lqdung24/stm32_quad/stm32cube/README.md

# Hướng dẫn đi dây drone STM32H743 + ESP32-S3

> **An toàn:** Tháo toàn bộ cánh quạt trước khi cấp nguồn hoặc thử motor.
> Không cấp nguồn motor/ESC từ STM32 hay ESP32.

## 1. Sơ đồ tổng quát

```text
Điện thoại
    │ Wi-Fi
    ▼
ESP32-S3 ── UART 460800 ── STM32H743 ── PWM/DShot ── ESC 1 ── Motor 1
    │                         │                       ESC 2 ── Motor 2
    │                         │                       ESC 3 ── Motor 3
    │                         │                       ESC 4 ── Motor 4
    │                         │
    GND───────────────────────GND──────────────────── GND các ESC

Pin/battery (+) ───────────────────────────────────── Nguồn động lực các ESC
Pin/battery (-) ───────────────────────────────────── GND nguồn động lực
```

Tất cả ESP32-S3, STM32 và ESC phải có **GND chung**.

## 2. ESP32-S3 nối STM32H743

ESP32-S3: VCC | GND | RX | TX

STM32: RX | TX | GND | VCC

| ESP32-S3 | STM32H743 | Chức năng |
| --- | --- | --- |
| GPIO17, UART1 TX | PA10, USART1 RX | Lệnh điều khiển ESP32 → STM32 |
| GPIO18, UART1 RX | PA9, USART1 TX  | Trạng thái STM32 → ESP32 |
| GND | GND | Mass tín hiệu chung |

Cấu hình UART hai bên:

- Baud rate: `460800`
- 8 data bits, no parity, 1 stop bit (`8N1`)
- Chế độ bất đồng bộ, TX/RX
- Mức logic `3.3 V`

Không nối UART vào điện áp `5 V`. Không dùng TX0/RX0 của ESP32-S3 nếu UART0
vẫn đang được dùng cho console/debug 115200 baud.

## Telemetry Wi-Fi 50 Hz

STM32 gửi packet `FLIGHT_TELEMETRY` 50 byte (có CRC) tối đa mỗi `20 ms` qua
UART. ESP chỉ giữ sample mới nhất rồi phát binary WebSocket ở
`ws://192.168.4.1/telemetry`; kênh điều khiển `/ws` vẫn độc lập. AP cho phép
hai thiết bị: điện thoại điều khiển và máy tính ghi/plot.

Các trường gồm timestamp STM32, roll/pitch/yaw (độ), gyro BODY-FRD và
rate-setpoint (rad/s), PID correction mixer, PWM M1..M4, `armed/state`, cờ
actuator active và cờ attitude valid. Trên máy tính, chạy từ thư mục gốc:

Trường wire `pwm_pulse_us` được giữ để tương thích protocol. Với DShot, giá trị
này là biểu diễn normalized tương đương 1000..2000, không phải DShot raw value.

```sh
python3 -m pip install websocket-client matplotlib
python3 tools/telemetry_plot.py --csv flight.csv
```

Lệnh thêm `--no-plot` để chỉ ghi CSV. Telemetry là best-effort và có thể bỏ
sample khi Wi-Fi chậm; nó không được phép làm chậm lệnh điều khiển.

## 3. STM32 nối bốn ESC

Chiều quay được xác định khi nhìn từ trên xuống drone. Ngưỡng idle cấu hình
có thêm `20 µs` so với mức motor bắt đầu quay đo được khi tháo cánh.

| Motor | Vị trí | STM32H743 | Timer | Chiều quay | Bắt đầu quay | Idle cấu hình |
| ----: | --- | --- | --- | --- | ---: | ---: |
| M1 | front-left  | PA6 | TIM3_CH1 | Thuận (CW) | `1200 µs` | `1220 µs` |
| M2 | rear-left | PA7 | TIM3_CH2 | Ngược (CCW) | `1205 µs` | `1225 µs` |
| M3 | front-right | PB0 | TIM3_CH3 | Ngược (CCW) | `1190 µs` | `1210 µs` |
| M4 | rear-right  | PB1 | TIM3_CH4 | Thuận (CW) | `1205 µs` | `1225 µs` |

Với mỗi ESC:

```text
STM32 PWM pin ───────── ESC Signal
STM32 GND ───────────── ESC Signal GND
Battery + ───────────── ESC Power +
Battery - ───────────── ESC Power -
Ba dây pha ESC ──────── Motor
```

Khi chọn giao thức PWM, cấu hình là:

- Tần số: `50 Hz`
- Disarm/throttle 0: `1000 µs`
- Throttle điện thoại `1..500` được map liên tục thành collective
  `1225..1800 µs`: `1 → 1225`, `100 → ~1339`, `250 → ~1512`,
  `400 → ~1685`, `500 → 1800 µs`.
- Khi armed và có PID correction, pulse từng motor vẫn được bảo vệ bởi idle
  riêng (`1220/1225/1210/1225 µs`).
- PID rate và Quad-X mixer có thể tạo pulse khác nhau cho bốn motor, tối đa
  `2000 µs`; collective tối đa `1800 µs` vẫn chừa headroom cho PID.

### Chọn DShot300 / DShot600

Tầng control luôn dùng cùng một API:

```c
float throttle[4] = {
  mix.command[0] / 1000.0f,
  mix.command[1] / 1000.0f,
  mix.command[2] / 1000.0f,
  mix.command[3] / 1000.0f,
};

MotorOutput_SetAllThrottle(&motors, throttle, 4U);
MotorOutput_Update(&motors);
```

Cấu hình hiện tại dùng DShot300 trong flow điều khiển bình thường:
`APP_DSHOT_TEST_ENABLE=0`. Motor khởi động ở trạng thái dừng và đi qua
ARM/DISARM, e-stop, watchdog, PID và mixer; không tự chạy ga sau 15 giây.

DShot300/600 cập nhật lệnh ESC ở **500 Hz (mỗi 2 ms)**; IMU/PID vẫn chạy
theo mẫu mới trong task 1 ms. UART và PID stage lệnh mới nhất; bước output
sau IMU/PID gửi đồng bộ bốn ESC, kể cả zero-throttle và MOTOR_TEST không có
packet mới. Pre-arm và bench cũng dùng 2 ms. DISARM/e-stop/failsafe dừng ngay,
không chờ chu kỳ gửi. DMA BUSY retry tick sau; deadline trễ không burst bù.
Đây là nhịp lệnh, bitrate DShot300/600 và PWM 50 Hz giữ nguyên. Đo nhịp frame
trên chân ESC khi bench không cánh để xác nhận timing thực tế.

Chọn giao thức trong `Components/App/Inc/app.h` hoặc build defines:

```c
#define APP_DSHOT_TEST_ENABLE 0U
#define APP_MOTOR_OUTPUT_PROTOCOL APP_MOTOR_OUTPUT_DSHOT300
/* Hoặc APP_MOTOR_OUTPUT_DSHOT600 / APP_MOTOR_OUTPUT_PWM */
```

Khi cần test giao thức riêng, chủ động đặt `APP_DSHOT_TEST_ENABLE=1`: gửi
giá trị `0` trong 15 giây rồi gửi ga `0.30f` (DShot value 648) cho cả bốn
motor mỗi 2 ms (500 Hz); flight task vẫn chạy mỗi 1 ms. Flow DShot600 giống hệt khi chọn `APP_MOTOR_OUTPUT_DSHOT600`.
Bench tự chạy, bỏ qua ARM/DISARM, e-stop và watchdog điều khiển; tháo cánh
và ngắt nguồn ESC để dừng test. Tắt test vẫn giữ DShot300 mặc định.
Cờ cũ `APP_DSHOT600_TEST_ENABLE=0` vẫn tắt bench; `=1` chọn bench DShot600
khi không có protocol override.

`Components/MotorDshot300` dùng chung encoder/DMA với `MotorDshot`; adapter
header-only không cần thêm source vào makefile CubeMX. TIM3_UP DMA1 Stream0
đã có trong source hiện tại. Khi regenerate, kiểm tra DMA, data width, NVIC
và thứ tự `MX_DMA_Init()` theo `Components/MotorDshot/README.md`.
Sau khi thêm các component mới, dùng **Refresh + Project Clean/Build** trong
CubeIDE để managed build sinh lại `Debug/Release` source lists; không sửa thủ
công các makefile tự sinh.

Nếu motor quay sai chiều, ngắt nguồn rồi đổi chéo **bất kỳ hai trong ba dây
pha** giữa ESC và motor.

### Dây đỏ 5 V/BEC của ESC

- Không nối dây 5 V/BEC vào chân `3V3`.
- Nếu STM32 và ESP32 đang được cấp nguồn bằng USB, để dây 5 V/BEC của ESC
  không kết nối.
- Nếu muốn dùng BEC để cấp nguồn board, chỉ dùng một nguồn 5 V đã kiểm tra và
  nối vào đúng chân `5V/VIN` theo sơ đồ của board. Không ghép song song nhiều
  đầu ra BEC nếu nhà sản xuất ESC không cho phép.

## 4. ICM20948 nối STM32 qua SPI1

| ICM20948 | STM32H743 | Chức năng  |
| --- | --- | --- |
| SCLK/SCL | PG11 | SPI1 SCK |
| SDO/AD0  | PG9 | SPI1 MISO |
| SDI/SDA  | PB5 | SPI1 MOSI |
| CS/NCS | PA4 | Chip select  |
| VCC | 3V3 | Nguồn logic |
| GND | GND | Mass chung |

Chỉ cấp `3.3 V` nếu module ICM20948 không có bộ ổn áp/chuyển mức riêng.

## 5. Checklist trước khi cấp điện

1. Tháo cánh quạt.
2. Dùng đồng hồ kiểm tra không chập `Battery +` với `GND`.
3. Xác nhận GPIO17 nối PA10 và GPIO18 nối PA9, không đấu TX với TX.
4. Nối GND ESP32, STM32 và cả bốn ESC với nhau.
5. Cấp nguồn logic cho ESP32/STM32 trước và kiểm tra web báo STM32 `ONLINE`.
6. Cấp nguồn động lực ESC.
7. Nhấn **DISARM / RESET**, sau đó giữ **ARM** một giây khi throttle bằng 0.
8. Tăng throttle chậm, kiểm tra từng motor và nút **DỪNG KHẨN CẤP**.

## 6. Lưu ý chân trên board

Các tên `PA6`, `PA7`, `PB0`, `PB1`, `PA9`, `PA10`, `PG9`, `PG11`, `PB5` và
`PA4` là tên chân của vi điều khiển STM32H743. Vị trí chân trên header phụ
thuộc board STM32 cụ thể; phải đối chiếu schematic/pinout của đúng board trước
khi cắm dây.
