lqdung24/stm32_quad/esp_controller/rfid_s3/README.md

# ESP32-S3 + MFRC522 card reader/copy tool

Standalone ESP-IDF firmware for an ESP32-S3-WROOM-1-N16R8. It uses the
[`abobija/rc522`](https://components.espressif.com/components/abobija/rc522)
ESP-IDF component for event-driven card detection and native MIFARE Classic
authentication, raw block reads, and verified raw block writes through the
ESP32-S3 native USB Serial/JTAG port.

## Wiring

| RC522 pin | ESP32-S3 | Notes |
|---|---:|---|
| 3.3V | 3V3 | Never connect the RC522 to 5 V |
| GND | GND | Common ground |
| SCK | GPIO10 | SPI2 clock |
| MOSI | GPIO11 | SPI2 controller to RC522 |
| SDA / SS | GPIO12 | SPI chip select; this is not I2C SDA |
| MISO | GPIO13 | RC522 to SPI2 controller |
| RST | GPIO14 | Reset |
| IRQ | not connected | Polling is used |

GPIO19/20 are deliberately left free for native USB D-/D+. GPIO0, GPIO3,
GPIO45, and GPIO46 are avoided because they are strapping pins.

## Build, flash, and connect

Use ESP-IDF v5.5 or newer:

```sh
idf.py -C rfid_s3 build
idf.py -C rfid_s3 -p /dev/ttyACM0 flash
idf.py -C rfid_s3 -p /dev/ttyACM0 monitor
```

Do not run a second serial monitor while issuing commands. Any serial terminal
can use the same native USB Serial/JTAG port. The baud-rate setting is ignored
by native USB.

## Commands

- `scan` reads UID, SAK, and ATQA.
- `read 4` authenticates and prints data block 4 as 32 hexadecimal characters.
- `write 4 00112233445566778899AABBCCDDEEFF` authenticates, writes block 4,
  reads it back, and prints the verified value.
- `key A all FFFFFFFFFFFF` sets an authentication key for every sector.
- `key B 7 A0A1A2A3A4A5` sets Key B for sector 7.
- `clear` resets all keys to `FFFFFFFFFFFF`.

Only MIFARE Classic Mini, 1K, and 4K geometry is supported. The firmware does
not guess keys. Block 0 and every sector trailer are intentionally excluded
from reads and writes, so access conditions and manufacturer data cannot be
changed from the console. Commands wait up to 10 seconds for a card.

Use this tool only with cards and systems you own or are authorized to test.
