lqdung24/stm32_quad/telemetry-reports/2026-10-06/telemetry_review.png

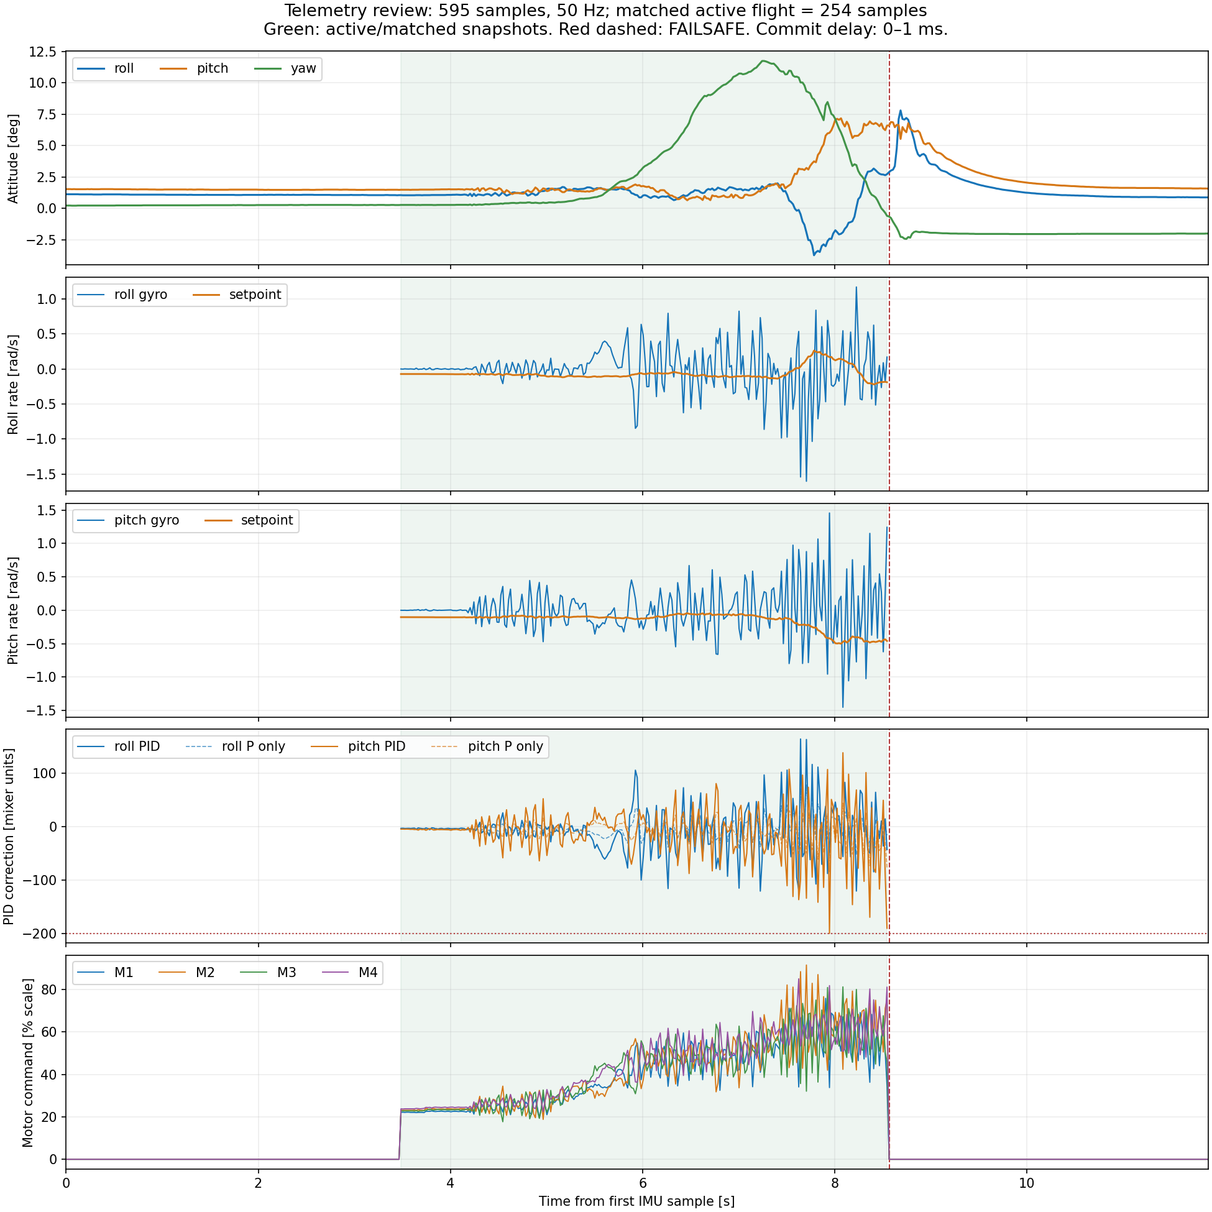
telemetry-reports/2026-10-06/telemetry_review.png
