lqdung24/stm32_quad/stm32cube/stm32_quad_dr.ioc

Mcu.UserName=STM32H743XIHx
PA10.Signal=USART1_RX
PA11.Signal=USB_OTG_FS_DM
PA12.Signal=USB_OTG_FS_DP
PA4.Signal=GPIO_Output
PA6.Signal=S_TIM3_CH1
PA7.Signal=S_TIM3_CH2
PA9.Signal=USART1_TX
PB0.Signal=S_TIM3_CH3
PB1.Signal=S_TIM3_CH4
PB5.Signal=SPI1_MOSI
PC13.Signal=GPIO_Output
PG11.Signal=SPI1_SCK
PG9.Signal=SPI1_MISO
PH7.Signal=GPIO_Output
