lqdung24/stm32_quad/stm32cube/Components/App/Inc/app.h

#ifndef APP_H
#define APP_H

#ifdef __cplusplus
extern "C" {
#endif

#include "stm32h7xx_hal.h"
#include <stdbool.h>
#include <stdint.h>

/*
 * Set to 1U to print ICM20948/AK09916 init, calibration, attitude and debug
 * logs. Motor command responses are independent and always remain enabled.
 */
#ifndef APP_ICM20948_LOG_ENABLE
#define APP_ICM20948_LOG_ENABLE 0U
#endif

/* Print received USART1 bytes as hexadecimal lines over USB CDC. */
#ifndef APP_UART1_RX_LOG_ENABLE
#define APP_UART1_RX_LOG_ENABLE 0U
#endif

/* Print one IMU/rate-loop timing summary per second over USB CDC. */
#ifndef APP_TIMING_LOG_ENABLE
#define APP_TIMING_LOG_ENABLE 1U
#endif

/* Print a RAM snapshot of PID/mixer/motor outputs at 10 Hz over USB CDC. */
#ifndef APP_MIXER_LOG_ENABLE
#define APP_MIXER_LOG_ENABLE 1U
#endif

#define APP_MOTOR_OUTPUT_PWM      0U
#define APP_MOTOR_OUTPUT_DSHOT600 1U
#define APP_MOTOR_OUTPUT_DSHOT300 2U

/* Normal control is the default. Opt in to bench debug only with propellers
 * removed. Honor the old DShot600 flag for existing build overrides. */
#ifndef APP_DSHOT_TEST_ENABLE
#ifdef APP_DSHOT600_TEST_ENABLE
#define APP_DSHOT_TEST_ENABLE APP_DSHOT600_TEST_ENABLE
#else
#define APP_DSHOT_TEST_ENABLE 0U
#endif
#endif
#if defined(APP_DSHOT600_TEST_ENABLE) && \
    (APP_DSHOT600_TEST_ENABLE != APP_DSHOT_TEST_ENABLE)
#error "Conflicting legacy and generic DShot bench flags"
#endif

#ifndef APP_MOTOR_OUTPUT_PROTOCOL
#if APP_DSHOT_TEST_ENABLE
#if defined(APP_DSHOT600_TEST_ENABLE) && APP_DSHOT600_TEST_ENABLE
#define APP_MOTOR_OUTPUT_PROTOCOL APP_MOTOR_OUTPUT_DSHOT600
#else
#define APP_MOTOR_OUTPUT_PROTOCOL APP_MOTOR_OUTPUT_DSHOT300
#endif
#else
#define APP_MOTOR_OUTPUT_PROTOCOL APP_MOTOR_OUTPUT_DSHOT300
#endif
#endif

#define APP_MOTOR_OUTPUT_IS_DSHOT \
    ((APP_MOTOR_OUTPUT_PROTOCOL == APP_MOTOR_OUTPUT_DSHOT300) || \
     (APP_MOTOR_OUTPUT_PROTOCOL == APP_MOTOR_OUTPUT_DSHOT600))

#if APP_DSHOT_TEST_ENABLE && !APP_MOTOR_OUTPUT_IS_DSHOT
#error "DShot bench test requires DShot300 or DShot600 output"
#endif
#if (APP_MOTOR_OUTPUT_PROTOCOL != APP_MOTOR_OUTPUT_PWM) && \
    !APP_MOTOR_OUTPUT_IS_DSHOT
#error "APP_MOTOR_OUTPUT_PROTOCOL must select PWM, DShot300 or DShot600"
#endif

typedef uint8_t (*App_UsbTransmitFn)(uint8_t *data, uint16_t length);

typedef struct
{
  uint32_t imu_sample_count;
  uint32_t data_not_ready_count;
  uint32_t read_error_count;
  uint32_t imu_rate_millihz;
  uint32_t imu_period_min_us;
  uint32_t imu_period_mean_us;
  uint32_t imu_period_max_us;
  uint32_t imu_read_min_us;
  uint32_t imu_read_mean_us;
  uint32_t imu_read_max_us;
  uint32_t pid_update_count;
  uint32_t pid_rate_millihz;
  uint32_t pid_period_min_us;
  uint32_t pid_period_mean_us;
  uint32_t pid_period_max_us;
  uint32_t pid_exec_min_us;
  uint32_t pid_exec_mean_us;
  uint32_t pid_exec_max_us;
  uint32_t pipeline_min_us;
  uint32_t pipeline_mean_us;
  uint32_t pipeline_max_us;
  bool cycle_counter_available;
} AppTimingStats;

void App_SetSpi(SPI_HandleTypeDef *hspi, GPIO_TypeDef *cs_port, uint16_t cs_pin);
void App_SetUsbTransmit(App_UsbTransmitFn transmit);
void App_SetActivityLed(GPIO_TypeDef *port, uint16_t pin);
void App_SetMotorTimer(TIM_HandleTypeDef *htim);
void App_SetControlUart(UART_HandleTypeDef *huart);

/* Called by USB callbacks; control execution remains in flightControl task. */
void App_OnUsbReceive(const uint8_t *data, uint32_t length);
void App_OnUsbTransmitComplete(void);

void App_Init(void);

/*
 * Compatibility entry point called by the CubeMX default task. It bootstraps
 * the hand-owned RTOS tasks and does not run the old cooperative super-loop.
 */
void App_Process(void);

/* Task-owned periodic steps. now_ms uses the STM32 HAL millisecond timebase. */
void App_FlightControlStep(uint32_t now_ms);
void App_TelemetryStep(uint32_t now_ms);
void App_HousekeepingStep(uint32_t now_ms);
bool App_GetTimingStats(AppTimingStats *stats);

#ifdef __cplusplus
}
#endif

#endif /* APP_H */
