lqdung24/stm32_quad/(commit log)

2026-07-31 rate pid, update icm ODR
2026-08-16 status led
2026-08-25 feat: ground controller
2026-08-25 feat: rfid read and write
    [flight_telemetry.csv]
2026-10-08 fix: esc config
    [drone-telemetry-2026-10-06T13-54-52-530Z.csv, drone-telemetry-2026-10-07T07-27-11-856Z.csv]
